rs-development/blackmagic-hardware/contrib/bmp22/bmp22/bmp22.kicad_pcb

## KiCad design contrib/bmp22/bmp22/bmp22.kicad_pcb (2020-08-07)

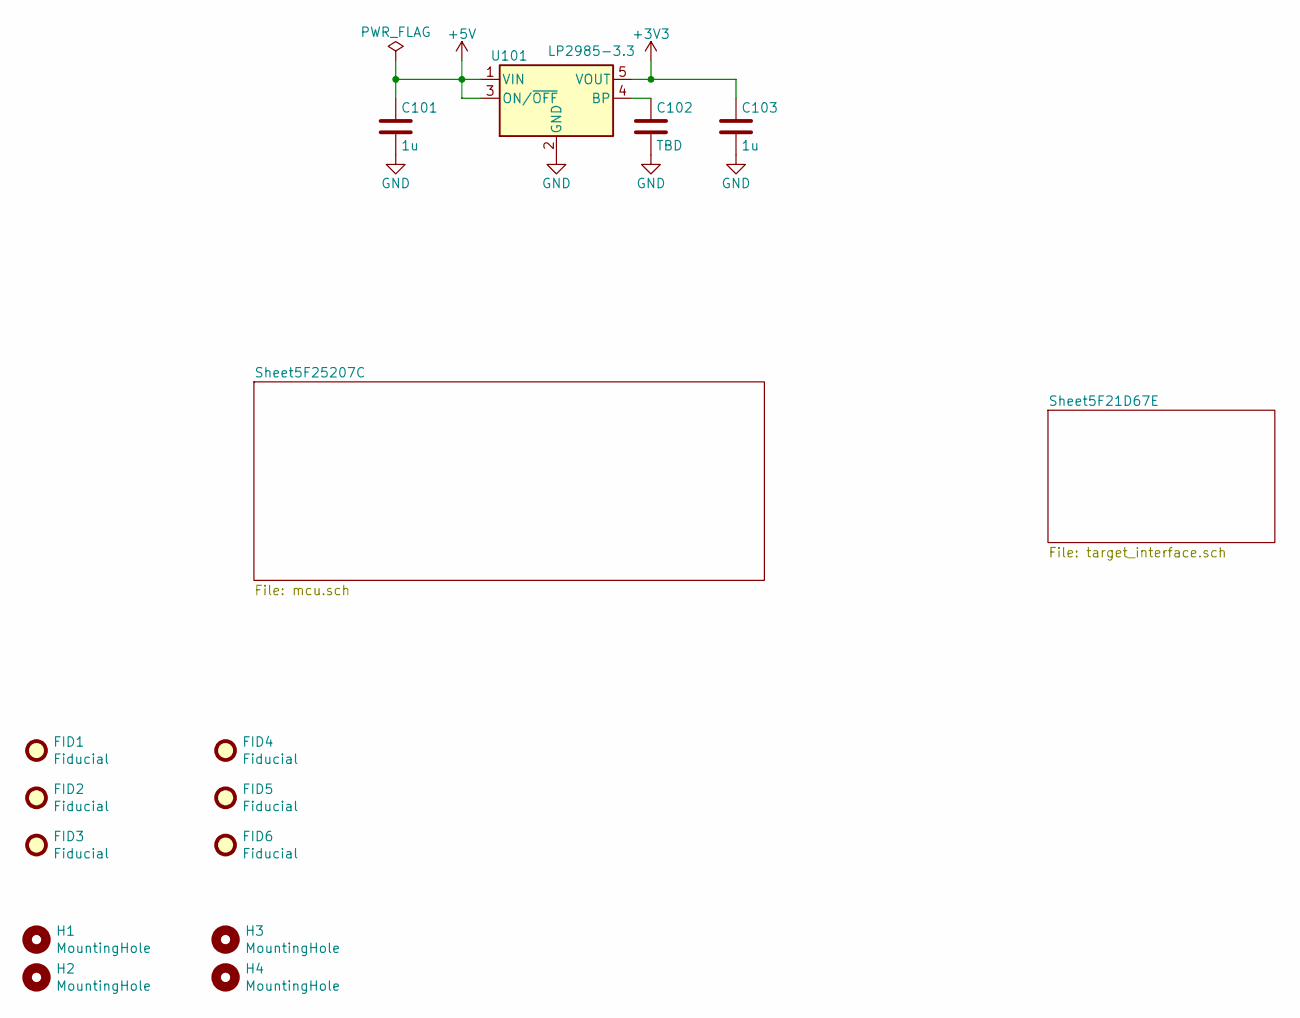
[picture p1: schematic bmp22.sch]

Parts:
C101, C103: 1u; C_0603_1608Metric
C102: TBD; C_0603_1608Metric
FID1, FID2, FID3, FID4, FID5, FID6: Fiducial; Fiducial_1mm_Mask2mm
H1, H2, H3, H4: MountingHole; MountingHole_2.7mm_M2.5_DIN965
U101: LP2985-3.3; SOT-23-5

Connections:
+3V3: C103.1, U101.5 (VOUT); also elsewhere on the board
+5V: C101.1, U101.1 (VIN), U101.3 (ON/~OFF~); also elsewhere on the board
GND: C101.2, C102.2, C103.2, U101.2 (GND); also elsewhere on the board
unnamed: C102.1, U101.4 (BP)

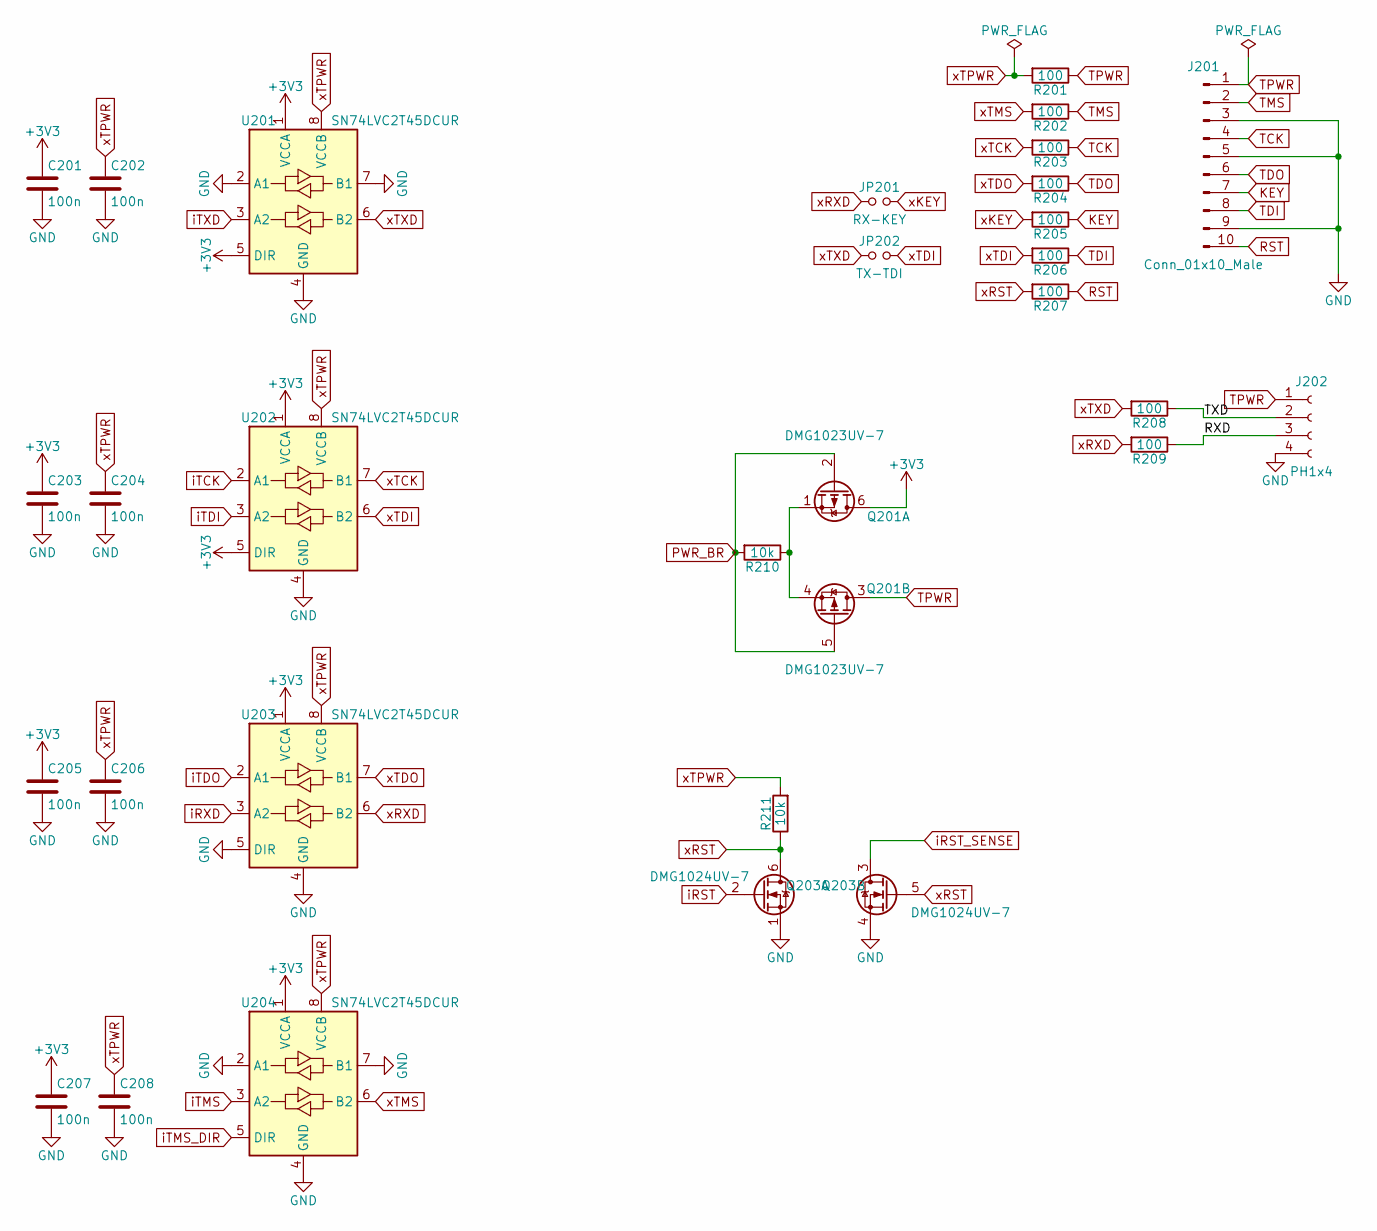
[picture p2: schematic target_interface.sch]

Parts:
C201, C202, C203, C204, C205, C206, C207, C208: 100n; C_0402_1005Metric
J201: Conn_01x10_Male; PinHeader_2x05_P1.27mm_Vertical_SMD
J202: PH1x4; JST_PH_S4B-PH-SM4-TB_1x04-1MP_P2.00mm_Horizontal
JP201: RX-KEY; R_0402_1005Metric
JP202: TX-TDI; R_0402_1005Metric
Q201: DMG1023UV-7; SOT-563
Q203: DMG1024UV-7; SOT-563
R201, R202, R203, R204, R205, R206, R207, R208, R209: 100; R_0402_1005Metric
R210, R211: 10k; R_0402_1005Metric
U201, U202, U203, U204: SN74LVC2T45DCUR; VSSOP-8_2.4x2.1mm_P0.5mm

Connections:
+3V3: C201.1, C203.1, C205.1, C207.1, Q201.6 (D), U201.1 (VCCA), U201.5 (DIR), U202.1 (VCCA), U202.5 (DIR), U203.1 (VCCA), U204.1 (VCCA); also elsewhere on the board
/Sheet5F21D67E/RXD: J202.3, R209.1
/Sheet5F21D67E/TXD: J202.2, R208.1
GND: C201.2, C202.2, C203.2, C204.2, C205.2, C206.2, C207.2, C208.2, J201.3, J201.5, J201.9, J202.4, Q203.1 (S), Q203.4 (S), U201.2 (A1), U201.4 (GND), U201.7 (B1), U202.4 (GND), U203.4 (GND), U203.5 (DIR), U204.2 (A1), U204.4 (GND), U204.7 (B1); also elsewhere on the board
KEY: J201.7, R205.1
unnamed: Q201.1 (S), Q201.4 (S), R210.1
PWR_BR: Q201.2 (G), Q201.5 (G), R210.2; also elsewhere on the board
RST: J201.10, R207.1
TCK: J201.4, R203.1
TDI: J201.8, R206.1
TDO: J201.6, R204.1
TMS: J201.2, R202.1
TPWR: J201.1, J202.1, Q201.3 (D), R201.1; also elsewhere on the board
iRST: Q203.2 (G); also elsewhere on the board
iRST_SENSE: Q203.3 (D); also elsewhere on the board
iRXD: U203.3 (A2); also elsewhere on the board
iTCK: U202.2 (A1); also elsewhere on the board
iTDI: U202.3 (A2); also elsewhere on the board
iTDO: U203.2 (A1); also elsewhere on the board
iTMS: U204.3 (A2); also elsewhere on the board
iTMS_DIR: U204.5 (DIR); also elsewhere on the board
iTXD: U201.3 (A2); also elsewhere on the board
xKEY: JP201.2, R205.2
xRST: Q203.5 (G), Q203.6 (D), R207.2, R211.1
xRXD: JP201.1, R209.2, U203.6 (B2)
xTCK: R203.2, U202.7 (B1)
xTDI: JP202.2, R206.2, U202.6 (B2)
xTDO: R204.2, U203.7 (B1)
xTMS: R202.2, U204.6 (B2)
xTPWR: C202.1, C204.1, C206.1, C208.1, R201.2, R211.2, U201.8 (VCCB), U202.8 (VCCB), U203.8 (VCCB), U204.8 (VCCB)
xTXD: JP202.1, R208.2, U201.6 (B2)

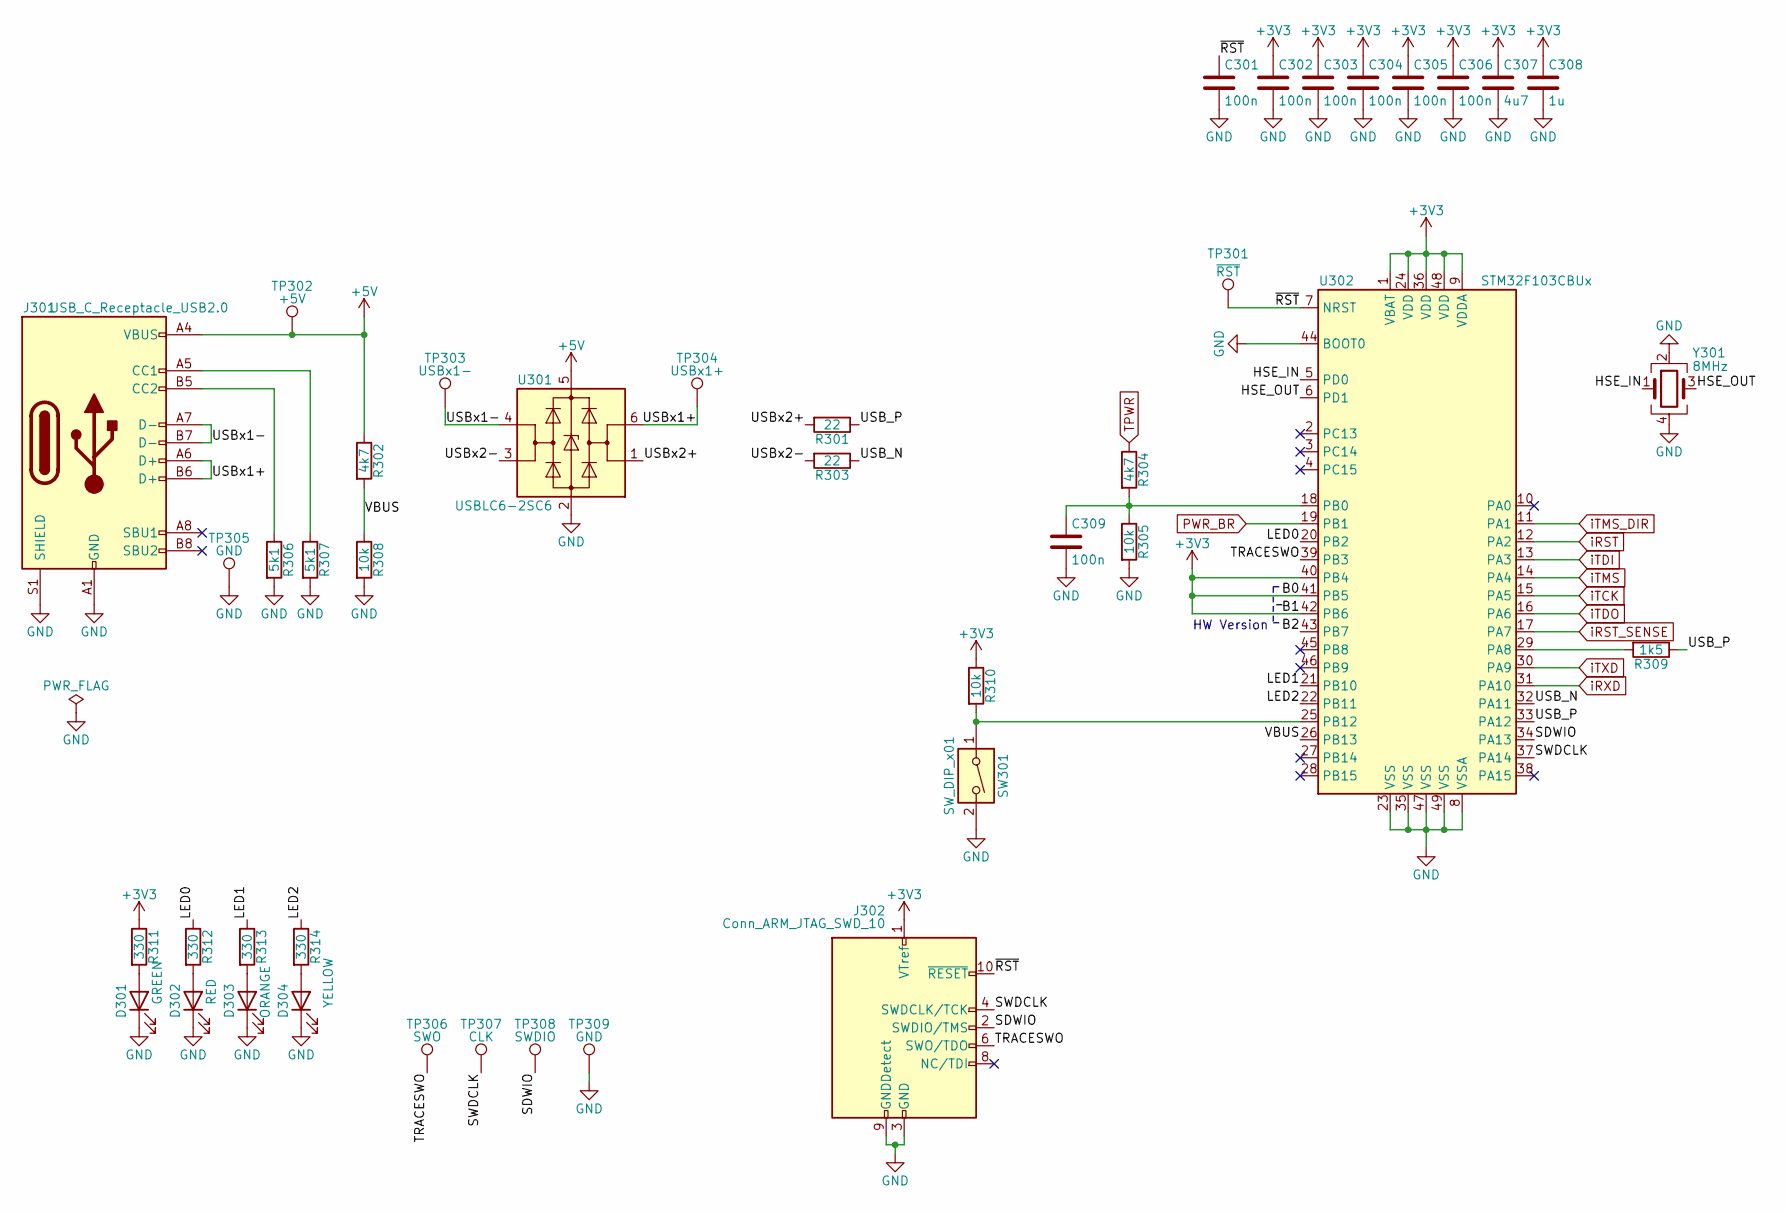
[picture p3: schematic mcu.sch]

Parts:
C301, C302, C303, C304, C305, C306, C309: 100n; C_0402_1005Metric
C307: 4u7; C_0603_1608Metric
C308: 1u; C_0603_1608Metric
D301: GREEN; LED_0603_1608Metric
D302: RED; LED_0603_1608Metric
D303: ORANGE; LED_0603_1608Metric
D304: YELLOW; LED_0603_1608Metric
J301: USB_C_Receptacle_USB2.0; USB_C_Receptacle_Palconn_UTC16-G
J302: Conn_ARM_JTAG_SWD_10; Tag-Connect_TC2050-IDC-NL_2x05_P1.27mm_Vertical
R301, R303: 22; R_0402_1005Metric
R302, R304: 4k7; R_0402_1005Metric
R305, R308, R310: 10k; R_0402_1005Metric
R306, R307: 5k1; R_0402_1005Metric
R309: 1k5; R_0402_1005Metric
R311, R312, R313, R314: 330; R_0402_1005Metric
SW301: SW_DIP_x01; SW_SPST_PTS810
TP301: ~RST; TestPoint_Pad_D1.5mm
TP302: +5V; TestPoint_Pad_D1.5mm
TP303: USBx1-; TestPoint_Pad_D1.5mm
TP304: USBx1+; TestPoint_Pad_D1.5mm
TP305, TP309: GND; TestPoint_Pad_D1.5mm
TP306: SWO; TestPoint_Pad_D1.5mm
TP307: CLK; TestPoint_Pad_D1.5mm
TP308: SWDIO; TestPoint_Pad_D1.5mm
U301: USBLC6-2SC6; SOT-23-6
U302: STM32F103CBUx; QFN-48-1EP_7x7mm_P0.5mm_EP5.6x5.6mm
Y301: 8MHz; Crystal_SMD_3225-4Pin_3.2x2.5mm

Connections:
+3V3: C302.1, C303.1, C304.1, C305.1, C306.1, C307.1, C308.1, J302.1 (VTref), R310.1, R311.1, U302.1 (VBAT), U302.9 (VDDA), U302.24 (VDD), U302.36 (VDD), U302.40 (PB4), U302.41 (PB5), U302.42 (PB6), U302.48 (VDD); also elsewhere on the board
+5V: J301.A4 (VBUS), J301.A9 (VBUS), J301.B4 (VBUS), J301.B9 (VBUS), R302.1, TP302.1, U301.5 (VBUS); also elsewhere on the board
/Sheet5F25207C/HSE_IN: U302.5 (PD0), Y301.1
/Sheet5F25207C/HSE_OUT: U302.6 (PD1), Y301.3
/Sheet5F25207C/LED0: R312.1, U302.20 (PB2)
/Sheet5F25207C/LED1: R313.1, U302.21 (PB10)
/Sheet5F25207C/LED2: R314.1, U302.22 (PB11)
/Sheet5F25207C/SDWIO: J302.2 (SWDIO/TMS), TP308.1, U302.34 (PA13)
/Sheet5F25207C/SWDCLK: J302.4 (SWDCLK/TCK), TP307.1, U302.37 (PA14)
/Sheet5F25207C/TRACESWO: J302.6 (SWO/TDO), TP306.1, U302.39 (PB3)
/Sheet5F25207C/USB_N: R303.1, U302.32 (PA11)
/Sheet5F25207C/USB_P: R301.1, R309.1, U302.33 (PA12)
/Sheet5F25207C/USBx1+: J301.A6 (D+), J301.B6 (D+), TP304.1, U301.6 (I/O1)
/Sheet5F25207C/USBx1-: J301.A7 (D-), J301.B7 (D-), TP303.1, U301.4 (I/O2)
/Sheet5F25207C/USBx2+: R301.2, U301.1 (I/O1)
/Sheet5F25207C/USBx2-: R303.2, U301.3 (I/O2)
/Sheet5F25207C/VBUS: R302.2, R308.1, U302.26 (PB13)
/Sheet5F25207C/~RST: C301.1, J302.10 (~RESET~), TP301.1, U302.7 (NRST)
GND: C301.2, C302.2, C303.2, C304.2, C305.2, C306.2, C307.2, C308.2, C309.2, D301.1 (K), D302.1 (K), D303.1 (K), D304.1 (K), J301.A1 (GND), J301.A12 (GND), J301.B1 (GND), J301.B12 (GND), J301.S1 (SHIELD), J302.3 (GND), J302.5 (GND), J302.9 (GNDDetect), R305.2, R306.2, R307.2, R308.2, SW301.2, TP305.1, TP309.1, U301.2 (GND), U302.8 (VSSA), U302.23 (VSS), U302.35 (VSS), U302.44 (BOOT0), U302.47 (VSS), U302.49 (VSS), Y301.2, Y301.4; also elsewhere on the board
unnamed: C309.1, R304.2, R305.1, U302.18 (PB0)
unnamed: D301.2 (A), R311.2
unnamed: D302.2 (A), R312.2
unnamed: D303.2 (A), R313.2
unnamed: D304.2 (A), R314.2
unnamed: J301.A5 (CC1), R307.1
unnamed: J301.B5 (CC2), R306.1
unnamed: R309.2, U302.29 (PA8)
unnamed: R310.2, SW301.1, U302.25 (PB12)
PWR_BR: U302.19 (PB1); also elsewhere on the board
TPWR: R304.1; also elsewhere on the board
iRST: U302.12 (PA2); also elsewhere on the board
iRST_SENSE: U302.17 (PA7); also elsewhere on the board
iRXD: U302.31 (PA10); also elsewhere on the board
iTCK: U302.15 (PA5); also elsewhere on the board
iTDI: U302.13 (PA3); also elsewhere on the board
iTDO: U302.16 (PA6); also elsewhere on the board
iTMS: U302.14 (PA4); also elsewhere on the board
iTMS_DIR: U302.11 (PA1); also elsewhere on the board
iTXD: U302.30 (PA9); also elsewhere on the board

Notes on the sheet:
HW Version

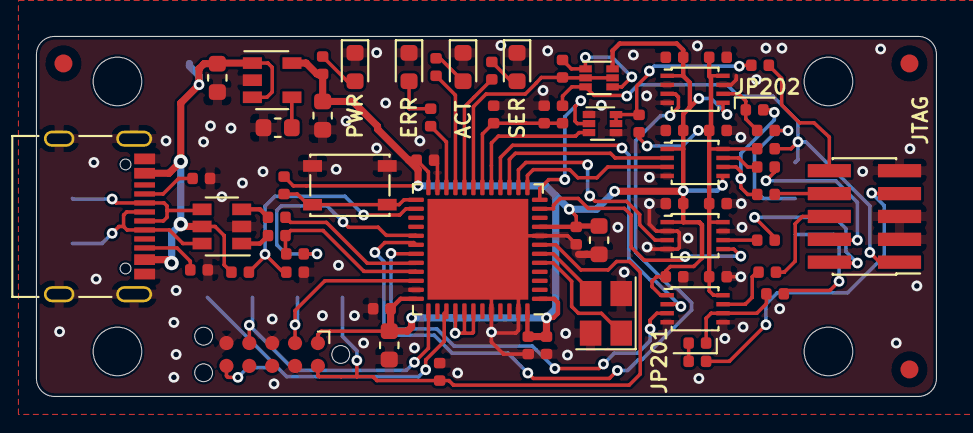
[picture p4: board bmp22.kicad_pcb from above]

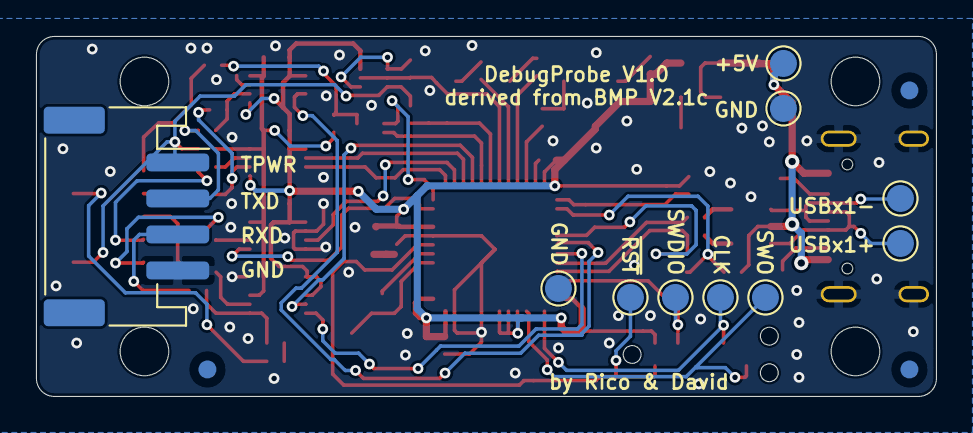
[picture p5: board bmp22.kicad_pcb from below]

Board: 2 copper layers, 50.0 x 20.0 mm, 85 parts (13 on the bottom side), 58 nets.
